emaneric/ROG-Flow-X13-Keyboard-mod/PCB/Laptop-Keyboard-Interface.kicad_pcb

## KiCad design PCB/Laptop-Keyboard-Interface.kicad_pcb (2026-05-14)

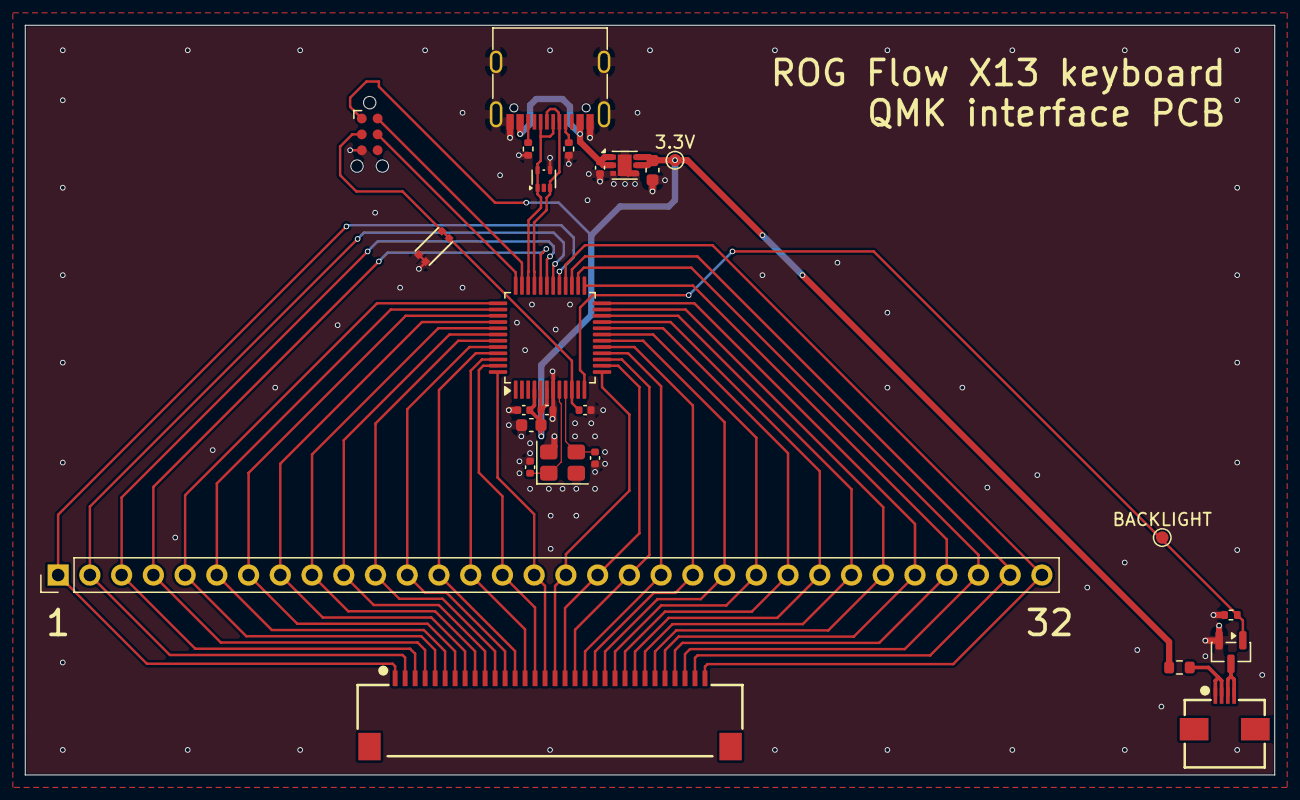
[picture p1: board Laptop-Keyboard-Interface.kicad_pcb from above]

Board: 2 copper layers, 100.0 x 60.0 mm, 25 parts (0 on the bottom side), 47 nets.

Parts:
3.3V: TestPoint; TestPoint_Pad_D1.0mm
BACKLIGHT: TestPoint; TestPoint_Pad_D1.0mm
C1: 1uF; C_0402_1005Metric
C2, C3: 10uF; C_0603_1608Metric
C4, C5, C8: 100nF; C_0402_1005Metric
C6, C7: 15pF; C_0402_1005Metric
J1: Conn_ARM_SWD_TagConnect_TC2030-NL; Tag-Connect_TC2030-IDC-NL_2x03_P1.27mm_Vertical
J2: USB_C_Receptacle_USB2.0_16P; USB_C_Receptacle_G-Switch_GT-USB-7010ASV
J3: Conn_01x32; THD0820-32CL-SN
J4: Conn_01x32; PinHeader_1x32_P2.54mm_Vertical
J5: Conn_01x04; AFC01-S04FCC-00
Q1: AO3400A; SOT-23
R1, R2: 5.1k; R_0402_1005Metric
R3: R; R_0603_1608Metric
R4: 100k; R_0402_1005Metric
SW1: SW_SPST_4_PIN; 1TS026A-2300-0553-CT
U1: NCP187; OnSemi_WDFN6_2x2_0.65P_CASE_511BR
U2: TPD2E2U06DRL; SOT-553
U3: STM32G0B1CBTx; LQFP-48_7x7mm_P0.5mm
Y1: Crystal_GND24; Crystal_SMD_3225-4Pin_3.2x2.5mm

Connections:
+3V3: 3.3V.1, C2.2, C3.2, C4.2, C5.2, J1.1 (VCC), R3.1, U1.5 (SNS), U1.6 (VOUT), U3.4 (VBAT), U3.5 (VREF+), U3.6 (VDD)
+5V: C1.2, J2.A4 (VBUS), J2.A9 (VBUS), J2.B4 (VBUS), J2.B9 (VBUS), U1.1 (VIN), U1.2 (EN)
/1: J3.1, J4.1, U3.29 (PA9/UCPD1_DBCC1)
/2: J3.2, J4.2, U3.30 (PC6)
/3: J3.3, J4.3, U3.31 (PC7)
/4: J3.4, J4.4, U3.32 (PA10/UCPD1_DBCC2)
/5: J3.5, J4.5, U3.37 (PA15)
/6: J3.6, J4.6, U3.38 (PD0)
/7: J3.7, J4.7, U3.39 (PD1)
/8: J3.8, J4.8, U3.40 (PD2)
/9: J3.9, J4.9, U3.41 (PD3)
/10: J3.10, J4.10, U3.42 (PB3)
/11: J3.11, J4.11, U3.43 (PB4)
/12: J3.12, J4.12, U3.44 (PB5)
/13: J3.13, J4.13, U3.45 (PB6)
/14: J3.14, J4.14, U3.46 (PB7)
/15: J3.15, J4.15, U3.47 (PB8)
/16: J3.16, J4.16, U3.48 (PB9)
/17: J3.17, J4.17, U3.13 (PA2)
/18: J3.18, J4.18, U3.14 (PA3)
/19: J3.19, J4.19, U3.15 (PA4)
/20: J3.20, J4.20, U3.16 (PA5)
/21: J3.21, J4.21, U3.17 (PA6)
/22: J3.22, J4.22, U3.18 (PA7)
/23: J3.23, J4.23, U3.19 (PB0)
/24: J3.24, J4.24, U3.20 (PB1)
/25: J3.25, J4.25, U3.21 (PB2)
/26: J3.26, J4.26, U3.22 (PB10)
/27: J3.27, J4.27, U3.23 (PB11)
/28: J3.28, J4.28, U3.24 (PB12)
/29: J3.29, J4.29, U3.25 (PB13)
/30: J3.30, J4.30, U3.26 (PB14)
/31: J3.31, J4.31, U3.27 (PB15)
/32: J3.32, J4.32, U3.28 (PA8)
/BACKLIGHT: BACKLIGHT.1, Q1.1 (G), R4.1, U3.12 (PA1)
/D+: J2.A6 (D+), J2.B6 (D+), U2.1 (NC), U2.5, U3.34 (PA10/PA12)
/D-: J2.A7 (D-), J2.B7 (D-), U2.3, U3.33 (PA9/PA11)
/NRST: C8.2, J1.3 (~RESET), SW1.1 (A), SW1.2 (A), U3.10 (PF2)
/SWCLK: J1.4 (SWCLK), U3.36 (PA14)
/SWDIO: J1.2 (SWDIO), U3.35 (PA13)
GND: C1.1, C2.1, C3.1, C4.1, C5.1, C6.1, C7.1, C8.1, J1.5 (GND), J2.A1 (GND), J2.A12 (GND), J2.B1 (GND), J2.B12 (GND), J2.S1 (SHIELD), Q1.2 (S), R1.2, R2.2, R4.2, SW1.3 (B), SW1.4 (B), U1.3 (GND), U1.4 (PG), U1.7 (EP), U2.4, U3.7 (VSS), Y1.2 (G), Y1.4 (G)
unnamed: J2.A5 (CC1), R1.1
unnamed: J2.B5 (CC2), R2.1
unnamed: J5.1, J5.2, R3.2
unnamed: J5.3, J5.4, Q1.3 (D)
unnamed: C6.2, U3.8 (PF0), Y1.1
unnamed: C7.2, U3.9 (PF1), Y1.3
