emaneric/ROG-Flow-X13-Keyboard-mod/Code/matrix-test-code/Core/Src/main.c

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
/* Includes ------------------------------------------------------------------*/
#include "main.h"
#include "usb_device.h"

/* USER CODE BEGIN Includes */
#include "usbd_hid.h"
#include <string.h>
#include <stdbool.h>
/* USER CODE END Includes */

/* USER CODE BEGIN PD */
#define CONSUMER_VOLDOWN  0xF0U
#define CONSUMER_VOLUP    0xF1U
#define CONSUMER_MUTE     0xF2U
/* USER CODE END PD */

TIM_HandleTypeDef htim2;

/* USER CODE BEGIN PV */
extern USBD_HandleTypeDef hUsbDeviceFS;

#define NUM_ROWS 9
#define NUM_COLS 20

typedef struct { GPIO_TypeDef *port; uint16_t pin; } GPIOPin_t;

static const GPIOPin_t row_pins[NUM_ROWS] = {
    {GPIOA, GPIO_PIN_3},   /* R0 */
    {GPIOA, GPIO_PIN_4},   /* R1 */
    {GPIOA, GPIO_PIN_6},   /* R2 */
    {GPIOA, GPIO_PIN_7},   /* R3 */
    {GPIOB, GPIO_PIN_1},   /* R4 */
    {GPIOB, GPIO_PIN_2},   /* R5 */
    {GPIOB, GPIO_PIN_8},   /* R6 */
    {GPIOB, GPIO_PIN_9},   /* R7 */
    {GPIOB, GPIO_PIN_12},  /* R8 */
};

static const GPIOPin_t col_pins[NUM_COLS] = {
    {GPIOA, GPIO_PIN_2},   /* C0  */
    {GPIOA, GPIO_PIN_5},   /* C1  */
    {GPIOA, GPIO_PIN_10},  /* C2  */
    {GPIOA, GPIO_PIN_15},  /* C3  */
    {GPIOB, GPIO_PIN_0},   /* C4  */
    {GPIOB, GPIO_PIN_3},   /* C5  */
    {GPIOB, GPIO_PIN_4},   /* C6  */
    {GPIOB, GPIO_PIN_5},   /* C7  */
    {GPIOB, GPIO_PIN_6},   /* C8  */
    {GPIOB, GPIO_PIN_7},   /* C9  */
    {GPIOB, GPIO_PIN_10},  /* C10 */
    {GPIOB, GPIO_PIN_11},  /* C11 */
    {GPIOD, GPIO_PIN_0},   /* C12 */
    {GPIOD, GPIO_PIN_1},   /* C13 */
    {GPIOD, GPIO_PIN_2},   /* C14 */
    {GPIOD, GPIO_PIN_3},   /* C15 */
    {GPIOA, GPIO_PIN_8},   /* C16 */
    {GPIOB, GPIO_PIN_13},  /* C17 */
    {GPIOB, GPIO_PIN_14},  /* C18 */
    {GPIOB, GPIO_PIN_15},  /* C19 */
};

/*
 * HID keycodes indexed by [row][col].
 * 0x00 = no key assigned
 * 0xE0-0xE7 = modifier keys (LCtrl, LShift, LAlt, LGui, RCtrl, RShift, RAlt, RGui)
 * All other values = standard HID keyboard usage codes
 */
static const uint8_t keycode_map[NUM_ROWS][NUM_COLS] = {
    /* C0    C1    C2    C3    C4    C5    C6    C7    C8    C9    C10   C11   C12   C13   C14   C15   C16   C17   C18   C19 */
    /* R0 PA3  */ { 0x00, 0x00, 0x4F, 0x00, 0x00, 0x31, 0x08, 0x00, 0x3B, 0x2D, 0x00, 0x0B, 0x00, 0x40, 0x00, 0x0A, 0x00, 0x00, 0x00, 0x00 },
    /* R1 PA4  */ { 0x00, 0x00, 0x4C, 0x2E, 0x00, 0x43, 0x39, 0x35, 0x16, 0x27, 0x00, 0x23, 0x00, 0x3E, 0x00, 0x22, 0x00, 0x00, 0x00, 0x00 },
    /* R2 PA6  */ { 0x00, 0x00, 0x00, 0x2A, 0x00, 0x26, 0x20, 0x1E, 0x1F, 0x13, 0x00, 0x24, 0x00, 0x25, 0x00, 0x21, 0x00, 0x00, 0x00, 0x00 },
    /* R3 PA7  */ { 0x00, 0x00, 0x00, 0x30, 0x00, 0x44, 0x3C, 0x00, 0x1A, 0x2F, 0x00, 0x18, 0x00, 0x0C, 0x50, 0x15, 0x00, 0x00, 0x00, 0x00 },
    /* R4 PB1  */ { 0x00, 0x00, 0x00, 0x07, 0x00, 0x0F, 0x00, 0x04, 0x29, 0x33, 0x00, 0x0D, 0x00, 0x0E, 0x00, 0x09, 0x00, 0x00, 0x00, 0x00 },
    /* R5 PB2  */ { 0x00, 0xE2, 0x41, 0x28, 0xE1, 0x51, 0x2C, 0x00, 0x1D, 0x52, 0x00, 0x11, 0xE0, 0x00, 0x00, 0x05, 0x00, 0x00, 0x00, 0x00 },
    /* R6 PB8  */ { 0x00, 0xE6, 0x00, 0x34, 0xE5, 0x37, 0x00, 0x14, 0x1B, 0x38, 0x06, 0x10, 0xE4, 0x36, 0x00, 0x19, 0x00, 0x00, 0x00, 0x00 },
    /* R7 PB9  */ { 0xE3, 0x00, 0x00, 0x00, 0x00, 0x12, 0x3D, 0x2B, 0x3A, 0x45, 0x00, 0x1C, 0x00, 0x3F, 0x42, 0x17, 0x00, 0x00, 0x00, 0x00 },
    /* R8 PB12 */{ 0x00, 0x00, 0x00, 0x00, 0x00, 0x00, 0x00, 0x00, 0x00, 0x00, 0x00, 0x00, 0x00, 0x00, 0x00, 0x00, CONSUMER_VOLDOWN, 0x00, CONSUMER_MUTE, CONSUMER_VOLUP },
};

static uint8_t curr_state[NUM_ROWS][NUM_COLS];
static uint8_t prev_state[NUM_ROWS][NUM_COLS];

/* 0xF0-0xF2 are internal markers for consumer keys, looked up in consumer_usage[]. */
static const uint16_t consumer_usage[] = {
    0x00EA,  /* 0xF0: Volume Decrement */
    0x00E9,  /* 0xF1: Volume Increment */
    0x00E2,  /* 0xF2: Mute            */
};

typedef struct {
    uint8_t report_id;  /* Always 1 */
    uint8_t modifiers;
    uint8_t reserved;
    uint8_t keycodes[6];
} KeyboardReport_t;

typedef struct {
    uint8_t  report_id;  /* Always 2 */
    uint16_t usage;      /* Consumer usage code; 0 = no key */
} __attribute__((packed)) ConsumerReport_t;

static const uint32_t brightness_levels[4] = {0, 333, 666, 1000};
static int brightness_idx = 2; /* start at medium brightness */

static uint32_t rog_press_tick = 0;
static bool     rog_armed      = false;
/* USER CODE END PV */

void SystemClock_Config(void);
static void MX_GPIO_Init(void);
static void MX_TIM2_Init(void);
/* USER CODE BEGIN 0 */

/*
 * Return true if any three pressed keys form three corners of a row/column
 * rectangle, which means a ghost key may appear at the fourth corner.
 */
static bool has_ghost(void)
{
    for (int r1 = 0; r1 < NUM_ROWS; r1++) {
        for (int c1 = 0; c1 < NUM_COLS; c1++) {
            if (!curr_state[r1][c1]) continue;
            for (int c2 = c1 + 1; c2 < NUM_COLS; c2++) {
                if (!curr_state[r1][c2]) continue;
                /* Two keys share row r1 at c1 and c2.  If any other row has
                 * a key in c1 or c2, we have three corners of a rectangle. */
                for (int r2 = 0; r2 < NUM_ROWS; r2++) {
                    if (r2 == r1) continue;
                    if (curr_state[r2][c1] || curr_state[r2][c2])
                        return true;
                }
            }
        }
    }
    return false;
}

static void enter_bootloader(void)
{
    HAL_TIM_PWM_Stop(&htim2, TIM_CHANNEL_2);
    USBD_Stop(&hUsbDeviceFS);
    USBD_DeInit(&hUsbDeviceFS);
    HAL_RCC_DeInit();
    HAL_DeInit();

    SysTick->CTRL = 0U;
    SysTick->LOAD = 0U;
    SysTick->VAL  = 0U;

    __disable_irq();
    for (int i = 0; i < (int)(sizeof(NVIC->ICER) / sizeof(NVIC->ICER[0])); i++) {
        NVIC->ICER[i] = 0xFFFFFFFFU;
        NVIC->ICPR[i] = 0xFFFFFFFFU;
    }

    /* STM32G0B1 system bootloader base address */
    const uint32_t boot_base = 0x1FFF0000U;
    typedef void (*BootJump_t)(void);
    BootJump_t boot_jump = (BootJump_t)(*(uint32_t *)(boot_base + 4U));
    __set_MSP(*(uint32_t *)boot_base);
    boot_jump();
}

/* Drive each row low in turn and read all column pins. */
static void scan_matrix(void)
{
    GPIO_InitTypeDef init = {0};
    for (int r = 0; r < NUM_ROWS; r++) {
        init.Pin   = row_pins[r].pin;
        init.Mode  = GPIO_MODE_OUTPUT_PP;
        init.Pull  = GPIO_NOPULL;
        init.Speed = GPIO_SPEED_FREQ_LOW;
        HAL_GPIO_Init(row_pins[r].port, &init);
        HAL_GPIO_WritePin(row_pins[r].port, row_pins[r].pin, GPIO_PIN_RESET);

        HAL_Delay(1); /* settle */

        for (int c = 0; c < NUM_COLS; c++) {
            curr_state[r][c] =
                (HAL_GPIO_ReadPin(col_pins[c].port, col_pins[c].pin) == GPIO_PIN_RESET) ? 1U : 0U;
        }

        init.Mode = GPIO_MODE_INPUT;
        init.Pull = GPIO_PULLUP;
        HAL_GPIO_Init(row_pins[r].port, &init);
    }
}

/* Build and send keyboard + consumer HID reports from the current key state. */
static void send_hid_report(void)
{
    KeyboardReport_t kb = {0};
    kb.report_id = 1U;

    ConsumerReport_t consumer = {0};
    consumer.report_id = 2U;

    if (!has_ghost()) {
        int key_count = 0;
        for (int r = 0; r < NUM_ROWS; r++) {
            for (int c = 0; c < NUM_COLS; c++) {
                if (!curr_state[r][c]) continue;
                uint8_t kc = keycode_map[r][c];
                if (kc == 0x00) continue;
                if (kc >= 0xF0U) {
                    consumer.usage = consumer_usage[kc - 0xF0U];
                } else if (kc >= 0xE0U) {
                    kb.modifiers |= (uint8_t)(1u << (kc - 0xE0U));
                } else if (key_count < 6) {
                    kb.keycodes[key_count++] = kc;
                }
            }
        }
    }

    USBD_HID_HandleTypeDef *hhid =
        (USBD_HID_HandleTypeDef *)hUsbDeviceFS.pClassDataCmsit[hUsbDeviceFS.classId];

    uint32_t t = HAL_GetTick();
    while (hhid && hhid->state == USBD_HID_BUSY && (HAL_GetTick() - t) < 10U) {}
    USBD_HID_SendReport(&hUsbDeviceFS, (uint8_t *)&kb, sizeof(kb));

    t = HAL_GetTick();
    while (hhid && hhid->state == USBD_HID_BUSY && (HAL_GetTick() - t) < 10U) {}
    USBD_HID_SendReport(&hUsbDeviceFS, (uint8_t *)&consumer, sizeof(consumer));
}
/* USER CODE END 0 */

/**
  * @brief  The application entry point.
  * @retval int
  */
int main(void)
{

  /* MCU Configuration--------------------------------------------------------*/

  /* Reset of all peripherals, Initializes the Flash interface and the Systick. */
  HAL_Init();

  /* Configure the system clock */
  SystemClock_Config();

  /* Initialize all configured peripherals */
  MX_GPIO_Init();
  MX_USB_Device_Init();
  MX_TIM2_Init();
  /* USER CODE BEGIN 2 */
  HAL_TIM_PWM_Start(&htim2, TIM_CHANNEL_2);
  __HAL_TIM_SET_COMPARE(&htim2, TIM_CHANNEL_2, brightness_levels[brightness_idx]);

  while (hUsbDeviceFS.dev_state != USBD_STATE_CONFIGURED) { HAL_Delay(10); }
  HAL_Delay(500);

  scan_matrix();
  memcpy(prev_state, curr_state, sizeof(curr_state));

  /* Send empty report so host starts in a clean state */
  KeyboardReport_t empty = {0};
  USBD_HID_SendReport(&hUsbDeviceFS, (uint8_t *)&empty, sizeof(empty));
  /* USER CODE END 2 */

  /* Infinite loop */
  /* USER CODE BEGIN WHILE */
  while (1)
  {
    /* USER CODE END WHILE */

    /* USER CODE BEGIN 3 */
    scan_matrix();

    /* Drive PC7 (caps lock LED via MOSFET) from bit 1 of the host LED report */
    {
        USBD_HID_HandleTypeDef *hhid =
            (USBD_HID_HandleTypeDef *)hUsbDeviceFS.pClassDataCmsit[hUsbDeviceFS.classId];
        HAL_GPIO_WritePin(GPIOC, GPIO_PIN_7,
            (hhid != NULL && (hhid->led_report[1] & 0x02U)) ? GPIO_PIN_SET : GPIO_PIN_RESET);
    }

    /* ROG key (R8 C17): short press cycles brightness; hold 5s enters bootloader */
    if (curr_state[8][17] && !prev_state[8][17]) {
        rog_press_tick = HAL_GetTick();
        rog_armed = true;
    }
    if (!curr_state[8][17] && prev_state[8][17] && rog_armed) {
        brightness_idx = (brightness_idx + 1) % 4;
        __HAL_TIM_SET_COMPARE(&htim2, TIM_CHANNEL_2, brightness_levels[brightness_idx]);
        rog_armed = false;
    }
    if (rog_armed && curr_state[8][17] && (HAL_GetTick() - rog_press_tick) >= 5000U) {
        enter_bootloader();
    }

    if (memcmp(curr_state, prev_state, sizeof(curr_state)) != 0) {
        send_hid_report();
        memcpy(prev_state, curr_state, sizeof(curr_state));
    }
  }
  /* USER CODE END 3 */
}

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
