emaneric/ROG-Flow-X13-Keyboard-mod/Code/matrix-test-code/matrix-test-code.ioc

Mcu.UserName=STM32G0B1CBTx
PA1.Signal=S_TIM2_CH2
PA10.Signal=GPIO_Input
PA13.Signal=SYS_SWDIO
PA14-BOOT0.Signal=SYS_SWCLK
PA15.Signal=GPIO_Input
PA2.Signal=GPIO_Input
PA3.Signal=GPIO_Input
PA4.Signal=GPIO_Input
PA5.Signal=GPIO_Input
PA6.Signal=GPIO_Input
PA7.Signal=GPIO_Input
PA8.Signal=GPIO_Input
PB0.Signal=GPIO_Input
PB1.Signal=GPIO_Input
PB10.Signal=GPIO_Input
PB11.Signal=GPIO_Input
PB12.Signal=GPIO_Input
PB13.Signal=GPIO_Input
PB14.Signal=GPIO_Input
PB15.Signal=GPIO_Input
PB2.Signal=GPIO_Input
PB3.Signal=GPIO_Input
PB4.Signal=GPIO_Input
PB5.Signal=GPIO_Input
PB6.Signal=GPIO_Input
PB7.Signal=GPIO_Input
PB8.Signal=GPIO_Input
PB9.Signal=GPIO_Input
PC7.Signal=GPIO_Output
PD0.Signal=GPIO_Input
PD1.Signal=GPIO_Input
PD2.Signal=GPIO_Input
PD3.Signal=GPIO_Input
