emaneric/ROG-Flow-X13-Keyboard-mod/(commit log)

2026-05-14 Initial commit: ROG Flow X13 keyboard mod
    KiCad PCB/schematic for the interface board and STM32G0B1
    matrix-scan firmware with USB HID keyboard output and
    software anti-ghosting.
    [Laptop-Keyboard-Interface.kicad_pcb, Laptop-Keyboard-Interface.kicad_sch]
2026-05-14 -Added PWM backlight control
2026-05-14 -Added jump to bootloader by holding ROG button
