emaneric/ROG-Flow-X13-Keyboard-mod/(notices)

Notices in the files:
Code/matrix-test-code/Core/Src/main.c:
Copyright (c) 2026 STMicroelectronics.
All rights reserved.
This software is licensed under terms that can be found in the LICENSE file
